aRGi-org/lamp/README.md

# lamp
electromaker/myminifactory competiton arduino code
lamp.ino is the code to be installed on arduino uno to run the lamp

you can find the lamp and the project here: https://www.myminifactory.com/object/3d-print-117595
