aRGi-org/lamp/lamp-led-holder.stl

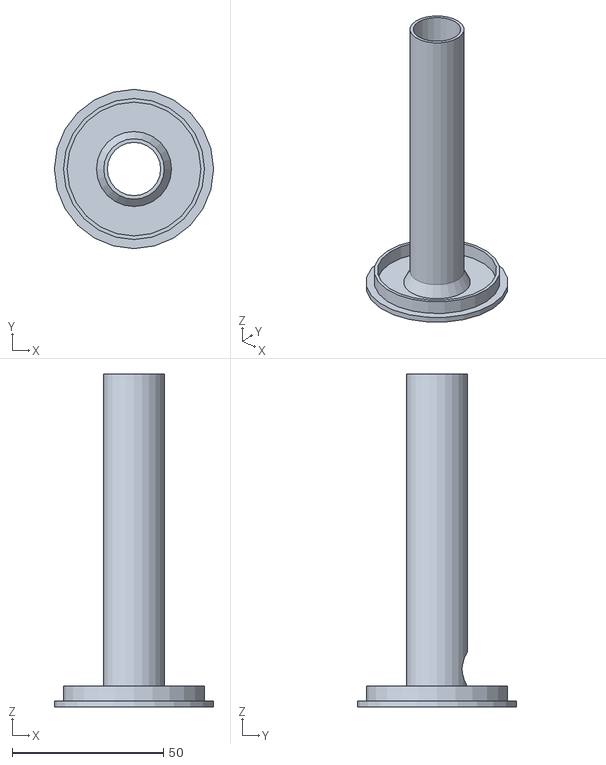
[picture p25: CAD file, 2020-04-21]
lamp-led-holder.stl
52.6 x 52.6 x 110.0
