aRGi-org/lamp/lamp-switch-potentiometers-cover.stl

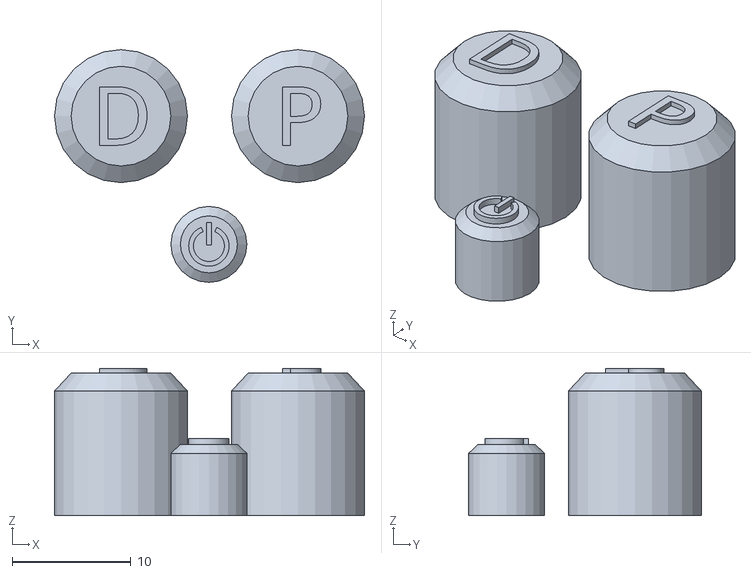
[picture p26: CAD file, 2020-04-21]
lamp-switch-potentiometers-cover.stl
26.1 x 19.6 x 12.4
