aRGi-org/lamp/lamp-base.stl

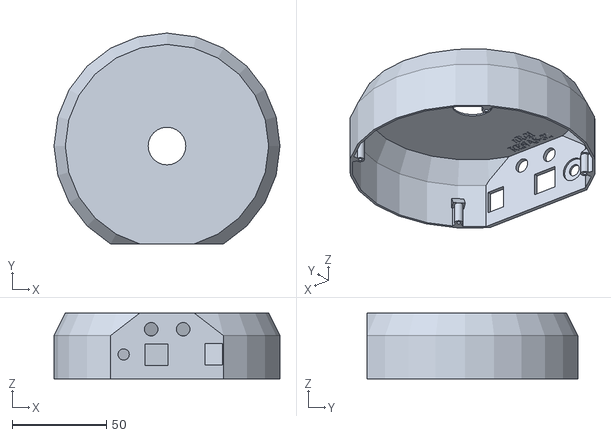
[picture p27: CAD file, 2020-04-21]
lamp-base.stl
120.0 x 112.0 x 35.0
