aRGi-org/lamp/lamp-shade.stl

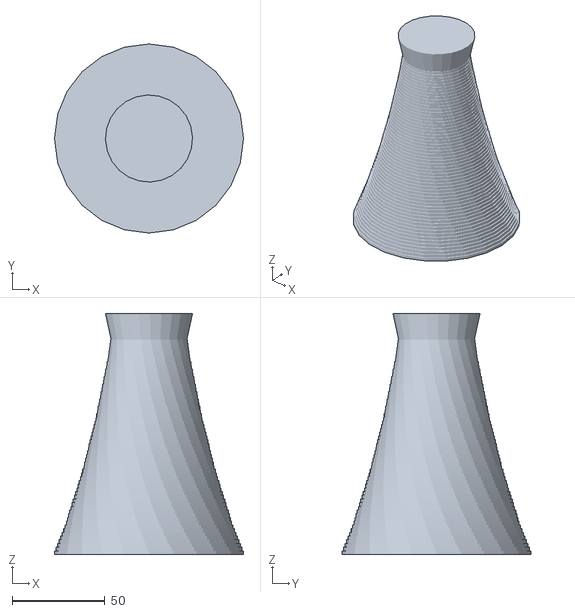
[picture p28: CAD file, 2020-04-21]
lamp-shade.stl
102.0 x 102.0 x 130.0
