aRGi-org/lamp/lamp-base-cover-electromaker-mod.stl

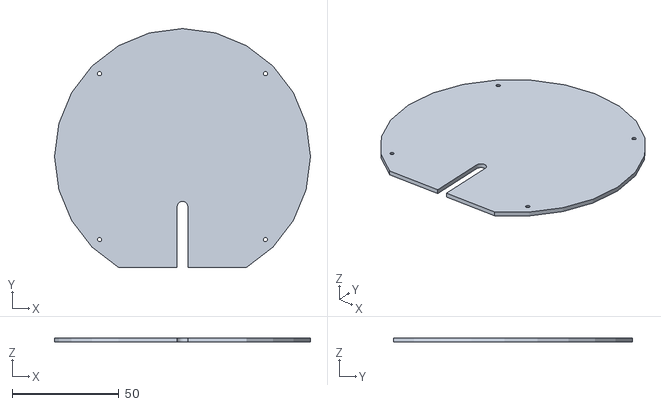
[picture p29: CAD file, 2020-04-21]
lamp-base-cover-electromaker-mod.stl
120.0 x 112.0 x 2.01
