aRGi-org/lamp/lamp-stem.stl

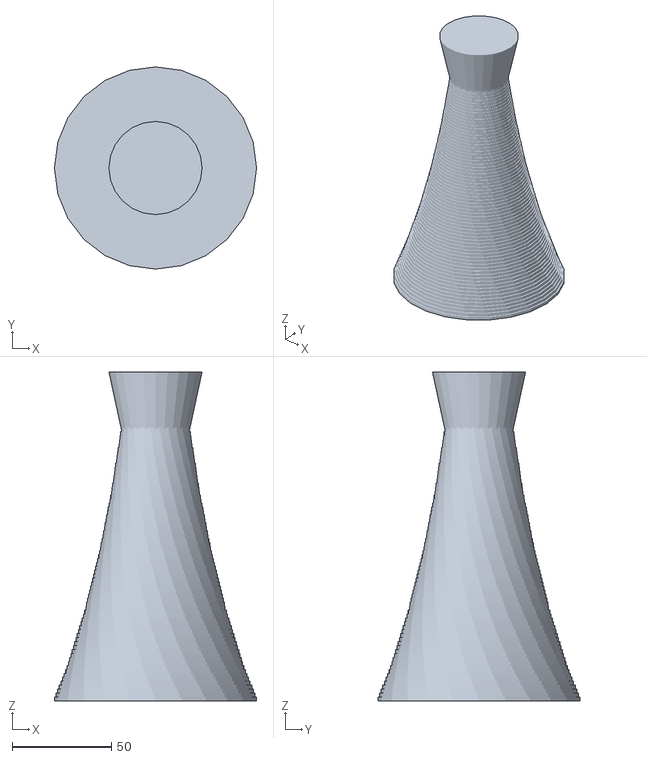
[picture p30: CAD file, 2020-04-21]
lamp-stem.stl
102.0 x 102.0 x 166.0
