aRGi-org/lamp/lamp-base-cover.stl

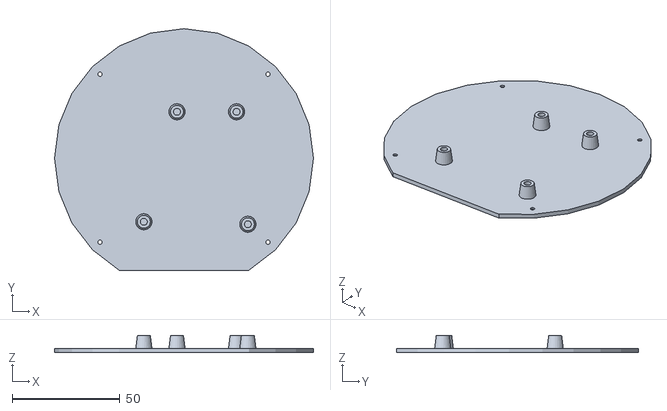
[picture p31: CAD file, 2020-04-21]
lamp-base-cover.stl
120.0 x 112.0 x 8.01
