aRGi-org/lamp/(list of files, cad)

Other CAD files:
lamp-base-electromaker-mod.stl
