aRGi-org/lamp/(list of files, drawings)

Other design files:
lamp.fzz
